alexander050706/Airwire/Sink/Untitled/JS102011SAQN/JS102011SAQN.step

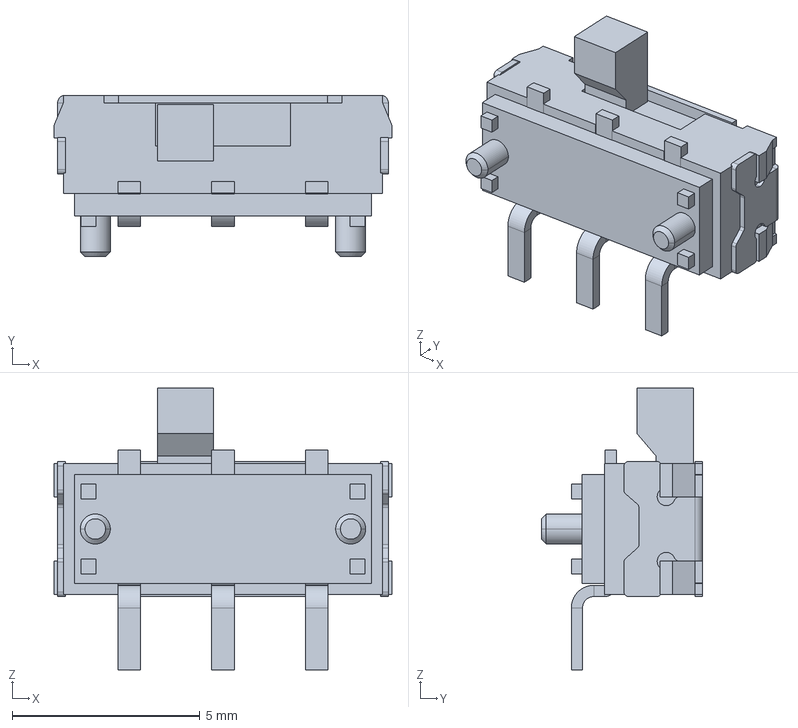
[picture p1: CAD file, 2026-10-18]
Sink/Untitled/JS102011SAQN/JS102011SAQN.step
9.00 x 4.30 x 7.50 mm
