alexander050706/Airwire/Sink/Untitled/Untitled.kicad_pcb

## KiCad design Sink/Untitled/Untitled.kicad_pcb (2026-10-18)

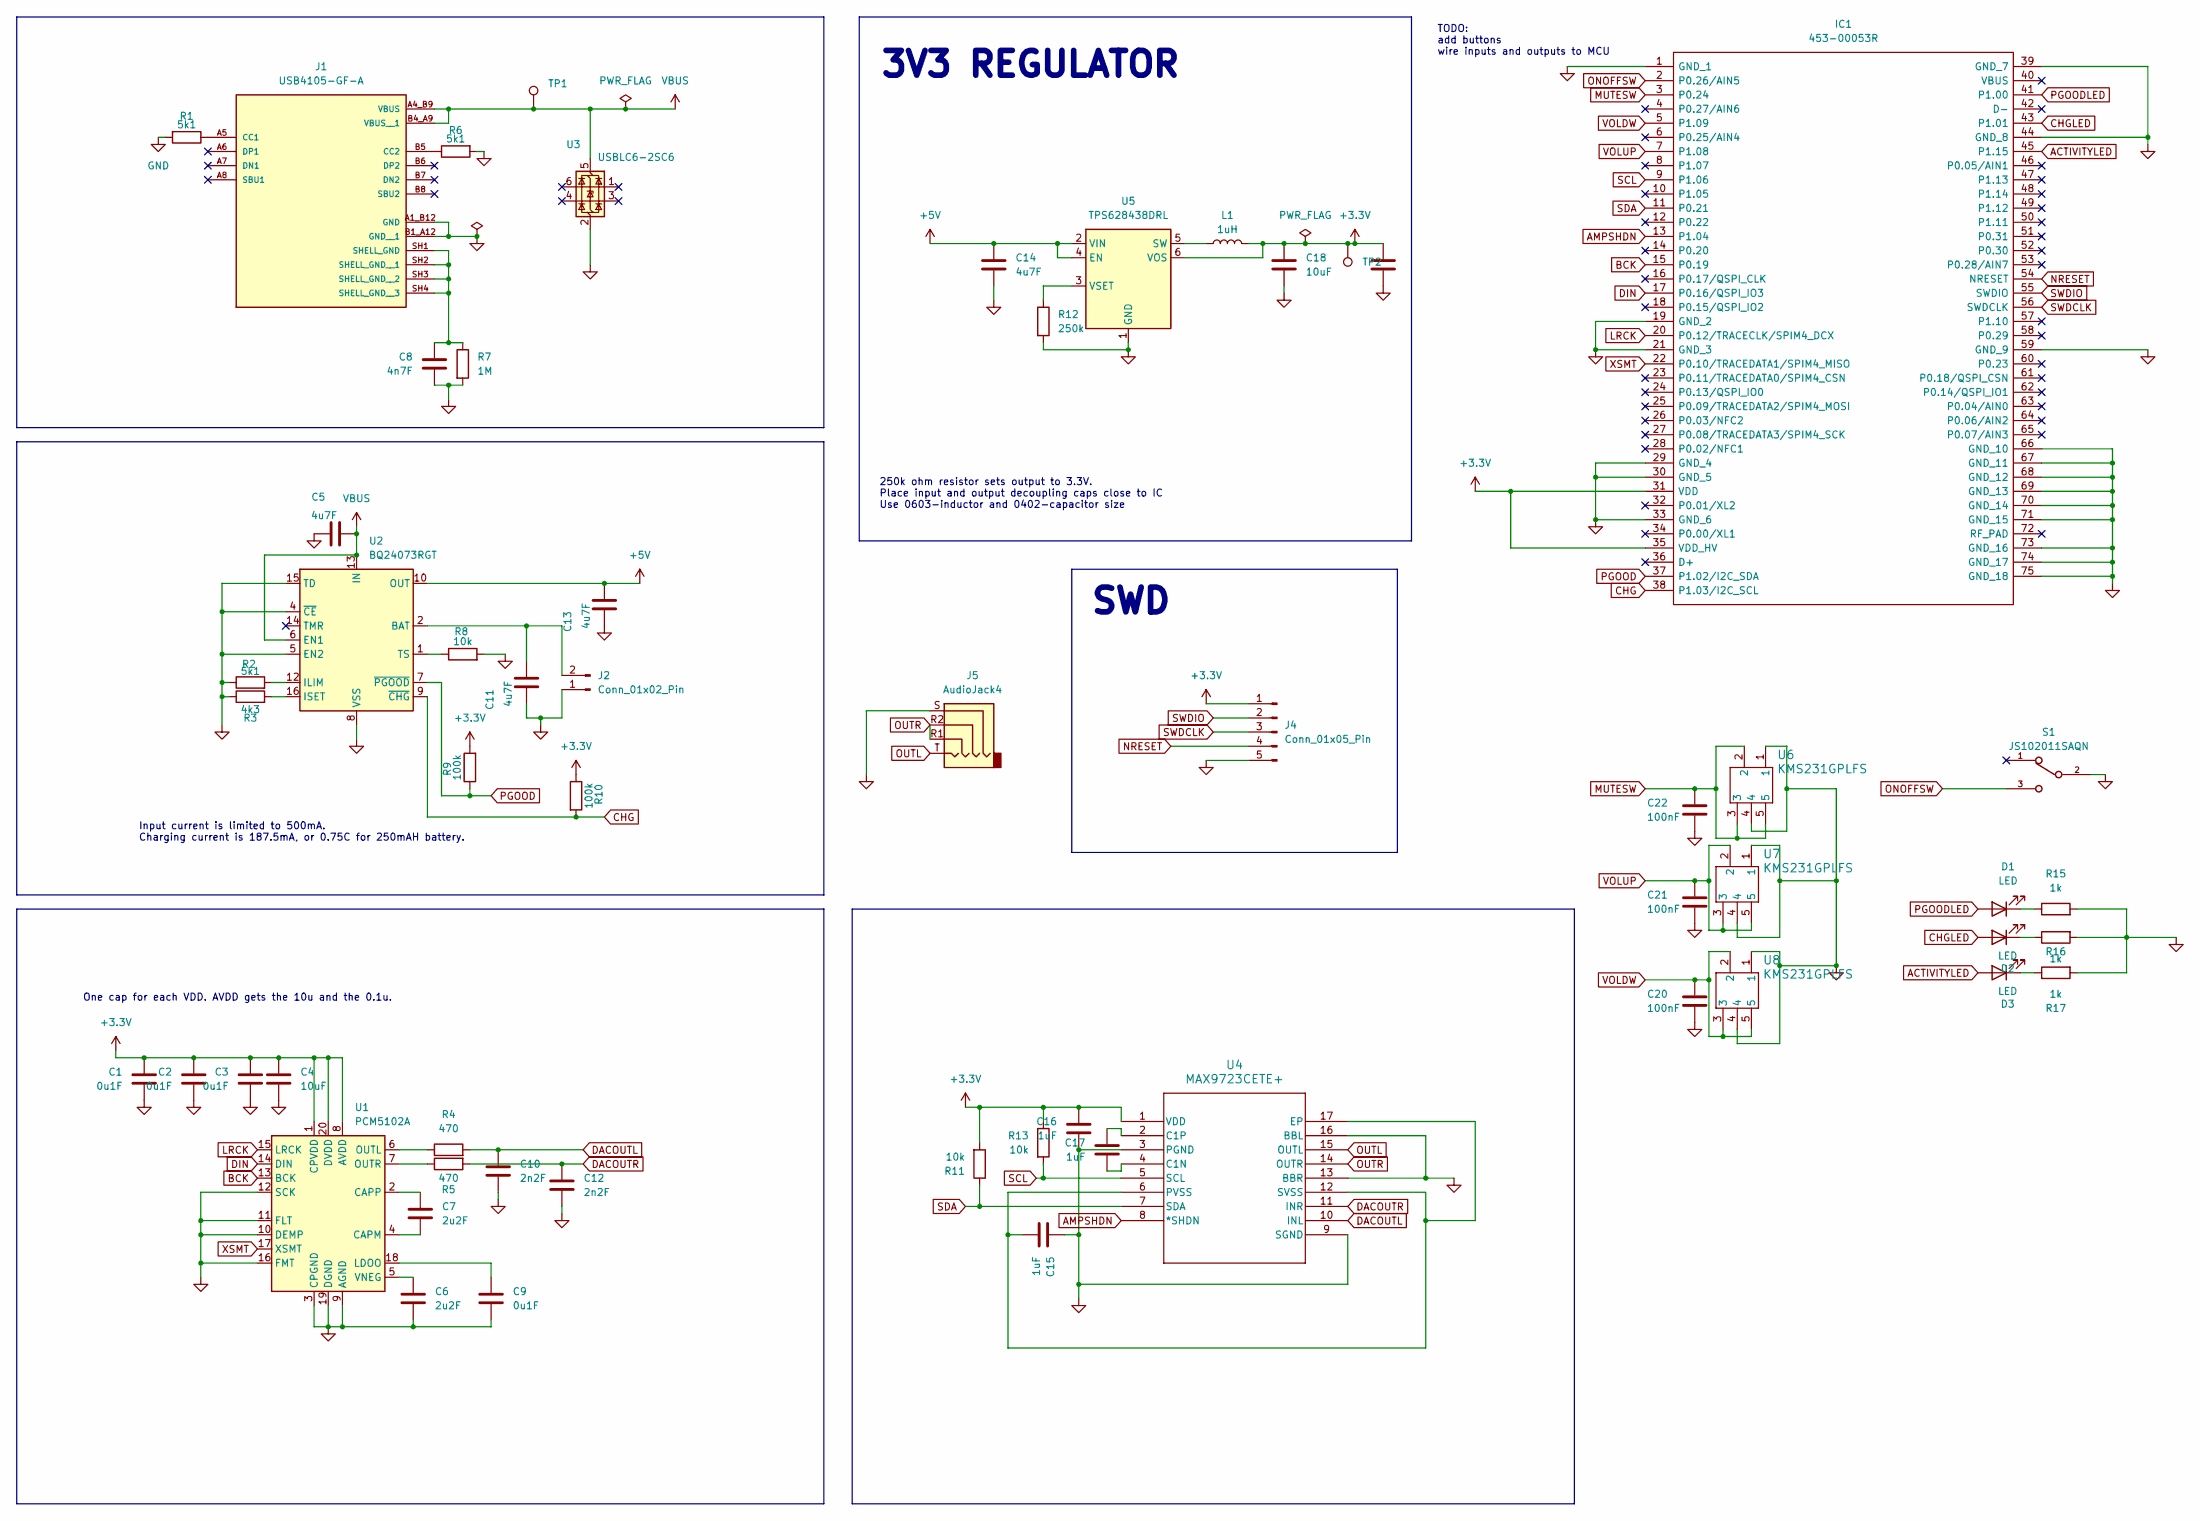
[picture p2: schematic Untitled.kicad_sch]

Parts:
C1, C2, C3, C9: 0u1F; C_0402_1005Metric_Pad0.74x0.62mm_HandSolder
C4: 10uF; C_0805_2012Metric_Pad1.18x1.45mm_HandSolder
C5, C11, C13: 4u7F; C_0402_1005Metric_Pad0.74x0.62mm_HandSolder
C6, C7: 2u2F; C_0805_2012Metric_Pad1.18x1.45mm_HandSolder
C8: 4n7F; C_0402_1005Metric_Pad0.74x0.62mm_HandSolder
C10, C12: 2n2F; C_0805_2012Metric_Pad1.18x1.45mm_HandSolder
C14: 4u7F; C_0402_1005Metric
C15, C16, C17: 1uF; C_0805_2012Metric
C18: 10uF; C_0402_1005Metric
C19: 10uF; C_0805_2012Metric
C20, C21, C22: 100nF; C_0603_1608Metric
D1, D2, D3: LED; LED_0402_1005Metric
IC1: 453-00053R; 45300053R; Manufacturer_Part_Number 453-00053R
J1: USB4105-GF-A; GCT_USB4105-GF-A; PARTREV B4
J2: Conn_01x02_Pin; PinHeader_2x01_P2.00mm_Vertical
J4: Conn_01x05_Pin; PinHeader_1x05_P2.54mm_Vertical
J5: AudioJack4; Jack_3.5mm_KoreanHropartsElec_PJ-320D-4A_Horizontal
L1: 1uH; L_0402_1005Metric
R1, R2, R6: 5k1; R_0402_1005Metric
R3: 4k3; R_0402_1005Metric
R4, R5: 470; R_0402_1005Metric
R7: 1M; R_0402_1005Metric
R8, R11, R13: 10k; R_0402_1005Metric
R9, R10: 100k; R_0402_1005Metric
R12: 250k; R_0402_1005Metric
R15, R16, R17: 1k; R_0402_1005Metric
S1: JS102011SAQN; SW_JS102011SAQN
TP1, TP2: TestPoint; TestPoint_Pad_D2.0mm
U1: PCM5102A; TSSOP-20_4.4x6.5mm_P0.65mm
U2: BQ24073RGT; VQFN-16-1EP_3x3mm_P0.5mm_EP1.6x1.6mm
U3: USBLC6-2SC6; SOT-23-6
U4: MAX9723CETE+; 21-0139P_T1644&plus_4_MXM
U5: TPS628438DRL; SOT-563
U6, U7, U8: KMS231GPLFS; SMT_231GPLFS

Connections:
+3.3V: C1.1, C2.1, C3.1, C4.1, C16.1, C18.1, C19.1, IC1.31 (VDD), IC1.35 (VDD_HV), J4.1, L1.2, R9.2, R10.1, R11.2, R13.1, TP2.1, U1.1 (CPVDD), U1.8 (AVDD), U1.20 (DVDD), U4.1 (VDD), U5.6 (VOS)
+5V: C13.2, C14.1, U2.10 (OUT), U2.11 (OUT), U5.2 (VIN), U5.4 (EN)
ACTIVITYLED: D3.2 (A), IC1.45 (P1.15)
AMPSHDN: IC1.13 (P1.04), U4.8 (*SHDN)
BCK: IC1.15 (P0.19), U1.13 (BCK)
CHG: IC1.38 (P1.03/I2C_SCL), R10.2, U2.9 (~CHG)
CHGLED: D2.2 (A), IC1.43 (P1.01)
DACOUTL: C10.1, R4.2, U4.10 (INL)
DACOUTR: C12.1, R5.2, U4.11 (INR)
DIN: IC1.17 (P0.16/QSPI_IO3), U1.14 (DIN)
GND: C1.2, C2.2, C3.2, C4.2, C5.1, C6.2, C8.2, C9.2, C10.2, C11.1, C12.2, C13.1, C14.2, C15.1, C16.2, C18.2, C19.2, C20.2, C21.2, C22.2, IC1.1 (GND_1), IC1.19 (GND_2), IC1.21 (GND_3), IC1.29 (GND_4), IC1.30 (GND_5), IC1.33 (GND_6), IC1.39 (GND_7), IC1.44 (GND_8), IC1.59 (GND_9), IC1.66 (GND_10), IC1.67 (GND_11), IC1.68 (GND_12), IC1.69 (GND_13), IC1.70 (GND_14), IC1.71 (GND_15), IC1.73 (GND_16), IC1.74 (GND_17), IC1.75 (GND_18), J1.A1_B12 (GND), J1.B1_A12 (GND__1), J2.1, J4.5, J5.S, R1.2, R2.1, R3.1, R6.2, R7.2, R8.2, R12.2, R15.2, R16.2, R17.2, S1.2, U1.3 (CPGND), U1.9 (AGND), U1.10 (DEMP), U1.11 (FLT), U1.12 (SCK), U1.16 (FMT), U1.19 (DGND), U2.4 (~CE), U2.5 (EN2), U2.8 (VSS), U2.15 (TD), U2.17 (VSS), U3.2 (GND), U4.3 (PGND), U4.9 (SGND), U4.13 (BBR), U4.16 (BBL), U5.1 (GND), U6.1, U6.4, U7.1, U7.4, U8.1, U8.4
LRCK: IC1.20 (P0.12/TRACECLK/SPIM4_DCX), U1.15 (LRCK)
MUTESW: C22.1, IC1.3 (P0.24), U6.2, U6.3, U6.5
NRESET: IC1.54 (NRESET), J4.4
unnamed: D1.1 (K), R15.1
unnamed: D2.1 (K), R16.1
unnamed: D3.1 (K), R17.1
unnamed: J1.A5 (CC1), R1.1
unnamed: J1.B5 (CC2), R6.1
unnamed: C8.1, J1.SH1 (SHELL_GND), J1.SH2 (SHELL_GND__1), J1.SH3 (SHELL_GND__2), J1.SH4 (SHELL_GND__3), R7.1
unnamed: C11.2, J2.2, U2.2 (BAT), U2.3 (BAT)
unnamed: C7.2, U1.4 (CAPM)
unnamed: C7.1, U1.2 (CAPP)
unnamed: C9.1, U1.18 (LDOO)
unnamed: R4.1, U1.6 (OUTL)
unnamed: R5.1, U1.7 (OUTR)
unnamed: C6.1, U1.5 (VNEG)
unnamed: R2.2, U2.12 (ILIM)
unnamed: R3.2, U2.16 (ISET)
unnamed: R8.1, U2.1 (TS)
unnamed: C17.2, U4.4 (C1N)
unnamed: C17.1, U4.2 (C1P)
unnamed: C15.2, U4.6 (PVSS), U4.12 (SVSS), U4.17 (EP)
unnamed: L1.1, U5.5 (SW)
unnamed: R12.1, U5.3 (VSET)
ONOFFSW: IC1.2 (P0.26/AIN5), S1.3
OUTL: J5.T, U4.15 (OUTL)
OUTR: J5.R1, J5.R2, U4.14 (OUTR)
PGOOD: IC1.37 (P1.02/I2C_SDA), R9.1, U2.7 (~PGOOD)
PGOODLED: D1.2 (A), IC1.41 (P1.00)
SCL: IC1.9 (P1.06), R13.2, U4.5 (SCL)
SDA: IC1.11 (P0.21), R11.1, U4.7 (SDA)
SWDCLK: IC1.56 (SWDCLK), J4.3
SWDIO: IC1.55 (SWDIO), J4.2
VBUS: C5.2, J1.A4_B9 (VBUS), J1.B4_A9 (VBUS__1), TP1.1, U2.6 (EN1), U2.13 (IN), U3.5 (VBUS)
VOLDW: C20.1, IC1.5 (P1.09), U8.2, U8.3, U8.5
VOLUP: C21.1, IC1.7 (P1.08), U7.2, U7.3, U7.5
XSMT: IC1.22 (P0.10/TRACEDATA1/SPIM4_MISO), U1.17 (XSMT)

Notes on the sheet:
Input current is limited to 500mA. Charging current is 187.5mA, or 0.75C for 250mAH battery.
One cap for each VDD. AVDD gets the 10u and the 0.1u.
3V3 REGULATOR
SWD
250k ohm resistor sets output to 3.3V. Place input and output decoupling caps close to IC Use 0603-inductor and 0402-capacitor size
TODO: add buttons wire inputs and outputs to MCU

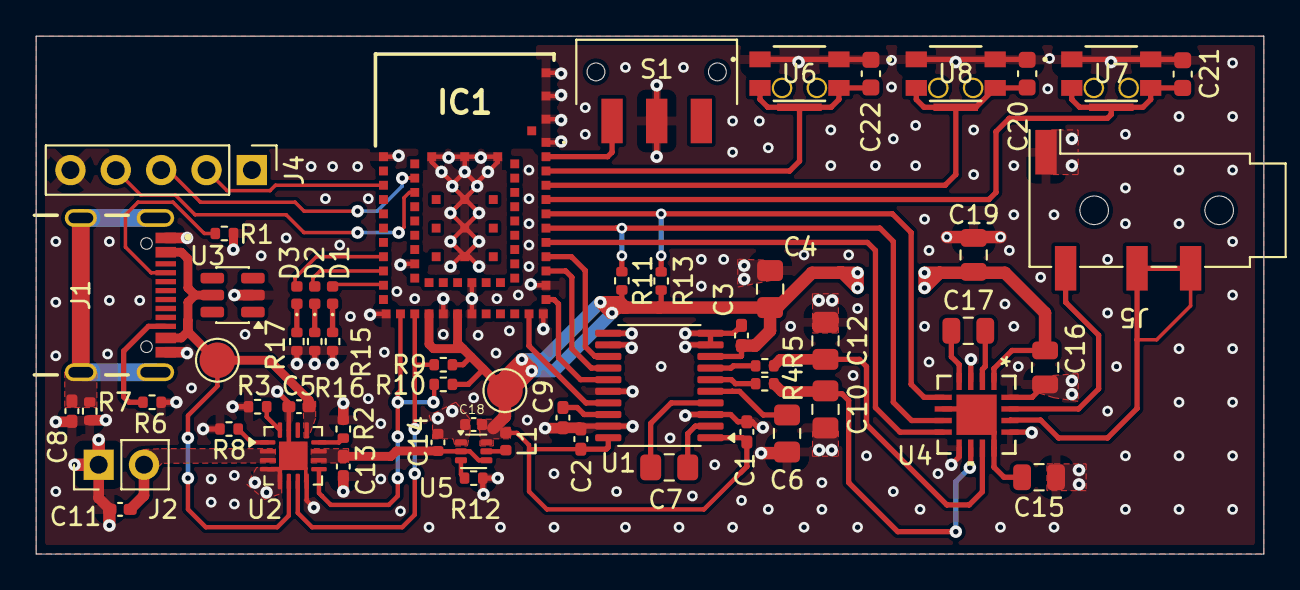
[picture p3: board Untitled.kicad_pcb from above]

Board: 2 copper layers, 68.8 x 29.0 mm, 58 parts (0 on the bottom side), 48 nets.
