alexander050706/Airwire/(commit log)

2026-10-18 Update README with PCB images
    Added images of the Source PCB and Receiver PCB to the README.
2026-10-18 Clarify project contributions and add PCB images
    Added clarification about project contributions and included additional images of the PCBs.
